tylerssims/TIDA_010042_beta_OEM_design_files/TIDA_010042_beta_OEM_design_files/Schematic - TIDRYU8B.PDF

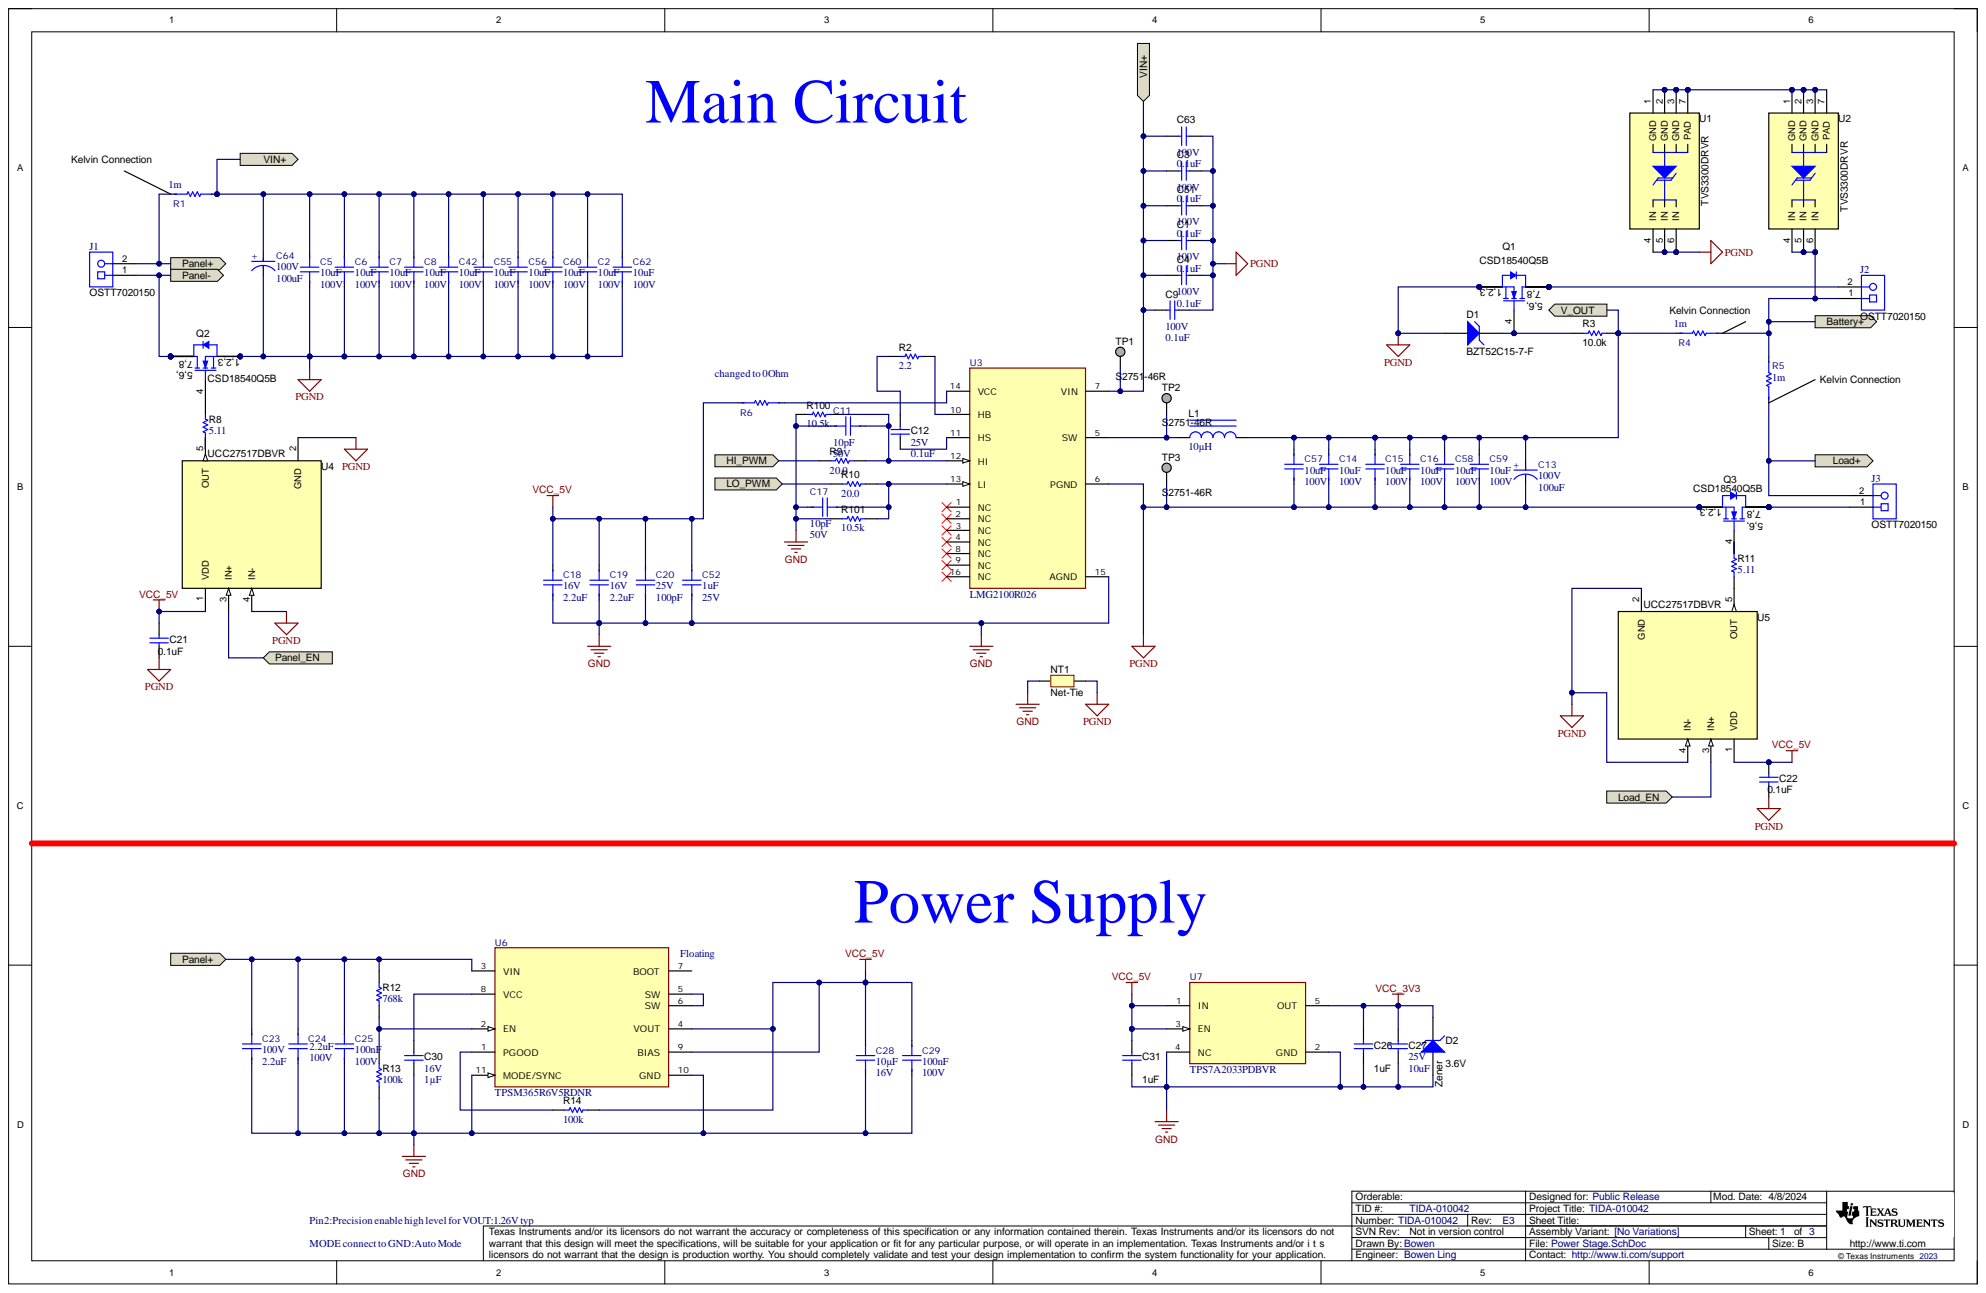
[picture p27: page 1]

MODE/SYNC 11

Designed for: Public Release

TID #: TIDA-010042 | Project Title: TIDA-010042
Number: TIDA-010042 | Rev: E3 | Sheet Title:
SVN Rev: Not in version control | Assembly Variant: [No Variations] | Sheet: 1 of 3

Pin2:Precision enable high levelfor VOUT:1.26V typ

Texas Instruments and/or its licensors do not warrant the accuracy or completeness of this specification or any information contained therein. Texas Instruments and/or its licensors do not
warrant that this design will meet the specifications, will be suitable for your application or fit for any particular purpose, or will operate in an implementation. Texas Instruments and/or its
licensors do not warrant that the design is production worthy. You should completely validate and test your design implementation to confirm the system functionality for your application.

MODE connect to GND:Auto Mode

Power Stage.SchDoc
File:
Contact: http://www.ti.com/support

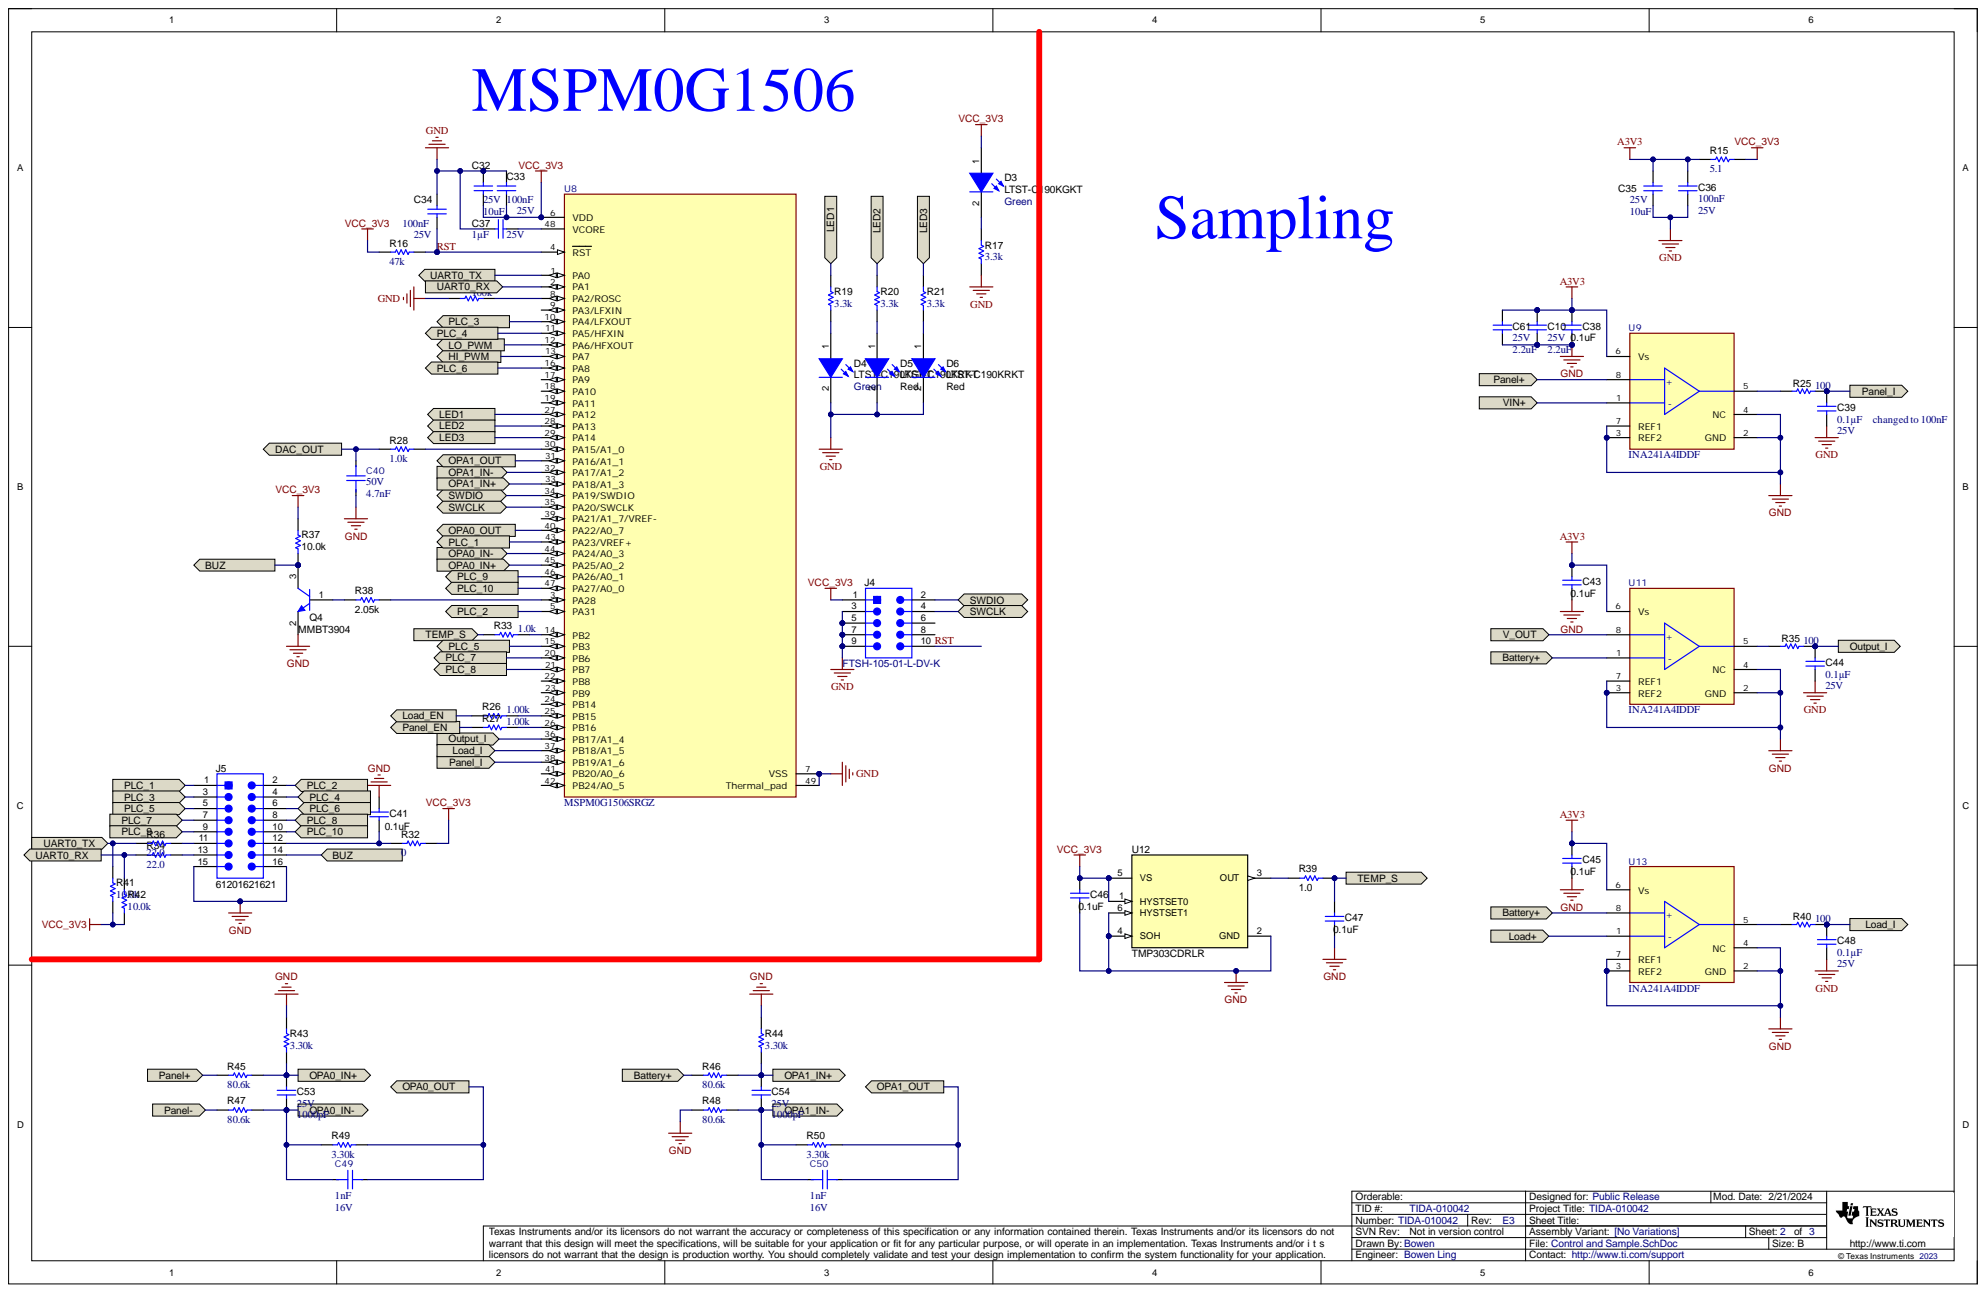
[picture p28: page 2]

C3

V s REF1

3 | REF2 GND | 2

TID # : TIDA - | P r oject Title : TIDA -
Nu m b e r : TIDA -2 | Rev: E | S h e et Title :
S VN Rev: Not in ve rsio n co ntr o l | Asse m bly V a ria nt: [No V a riatio ns] | S h e et: o

http://www.ti.co

D | D
C | C
B | B
A | A

10/20/2023

TIDA-010042_Hardware.SchDoc

Size:

Mod. Date:

File:

B | http://www.ti.com
Contact: http://www.ti.com/support
TID #: TIDA-010042 | Project Title: TIDA-010042
Number: TIDA-010042 | Rev: E3 | Sheet Title:
| SVN Rev: Not in version control | Assembly Variant: [No Variations] | Sheet: 3 of 3

Designed for: Public Release

© Texas Instruments 2023

Drawn By:
Engineer: Bowen Ling

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

Orderable:

## LOGO

## PCB

Texas Instruments

H1

NY PMS 440 0025 PH

H2

NY PMS 440 0025 PH

H3

NY PMS 440 0025 PH

H4

NY PMS 440 0025 PH

Label Assembly Note

ZZ1

This Assembly Note is for PCB labels only

Size: 0.65" x 0.20 "

## PCB Label

LBL1

THT-14-423-10

Assembly Note

ZZ2

These assemblies are ESD sensitive, ESD precautions shall be observed.

Assembly Note

ZZ3

These assemblies must be clean and free from flux and all contaminants. Use of no clean flux is not acceptable.

Assembly Note

ZZ4

These assemblies must comply with workmanship standards IPC-A-610 Class 2, unless otherwise specified.

## Variant/Label Table

Variant | Label Text
001 | ChangeMe!
002 | ChangeMe!

CE Mark

## LOGO

## PCB

FCC disclaimer

## LOGO

## PCB

WEEE logo

# IMPORTANT NOTICE AND DISCLAIMER

TI PROVIDES TECHNICAL AND RELIABILITY DATA (INCLUDING DATA SHEETS), DESIGN RESOURCES (INCLUDING REFERENCE DESIGNS), APPLICATION OR OTHER DESIGN ADVICE, WEB TOOLS, SAFETY INFORMATION, AND OTHER RESOURCES “AS IS” AND WITH ALL FAULTS, AND DISCLAIMS ALL WARRANTIES, EXPRESS AND IMPLIED, INCLUDING WITHOUT LIMITATION ANY IMPLIED WARRANTIES OF MERCHANTABILITY, FITNESS FOR A PARTICULAR PURPOSE OR NON-INFRINGEMENT OF THIRD PARTY INTELLECTUAL PROPERTY RIGHTS.
These resources are intended for skilled developers designing with TI products. You are solely responsible for (1) selecting the appropriate TI products for your application, (2) designing, validating and testing your application, and (3) ensuring your application meets applicable standards, and any other safety, security, regulatory or other requirements.
These resources are subject to change without notice. TI grants you permission to use these resources only for development of an application that uses the TI products described in the resource. Other reproduction and display of these resources is prohibited. No license is granted to any other TI intellectual property right or to any third party intellectual property right. TI disclaims responsibility for, and you will fully indemnify TI and its representatives against, any claims, damages, costs, losses, and liabilities arising out of your use of these resources.
TI’s products are provided subject to TI’s Terms of Sale (https://www.ti.com/legal/terms-conditions/terms-of-sale.html) or other applicable terms available either on ti.com or provided in conjunction with such TI products. TI’s provision of these resources does not expand or otherwise alter TI’s applicable warranties or warranty disclaimers for TI products.
TI objects to and rejects any additional or different terms you may have proposed. IMPORTANT NOTICE

## Mailing Address: Texas Instruments, Post Office Box 655303, Dallas, Texas 75265 Copyright © 2024, Texas Instruments Incorporated
