tylerssims/TIDA_010042_beta_OEM_design_files/(list of files, drawings)

Other design files:
TIDA_010042_beta_OEM_design_files/CAD_CAE symbol - TIDRYV2B/Control and Sample.SchDoc
TIDA_010042_beta_OEM_design_files/CAD_CAE symbol - TIDRYV2B/Power Stage.SchDoc
TIDA_010042_beta_OEM_design_files/CAD_CAE symbol - TIDRYV2B/TIDA-010042-E3.PrjPcb
TIDA_010042_beta_OEM_design_files/CAD_CAE symbol - TIDRYV2B/TIDA-010042-E3_4layer_v2.PrjPcb
TIDA_010042_beta_OEM_design_files/CAD_CAE symbol - TIDRYV2B/TIDA-010042_Hardware.SchDoc
